WinkYoo/basic_bluetooth_car/README.md

# 项目名称：基础蓝牙小车

# 开发时间：2026.5.4 - 2026.5.8

# 开发板：STM32F103RCT6(正点原子mini)

# 开发工具：STM32CubeMX+Keil5

# 硬件模块：TB6612FNG电机驱动模块，HC-05蓝牙模块，LM2596降压模块，2块12v3500mA电池包

# 

# 功能描述：该小车类型为前驱小车。上电之后系统会发送‘system ready’，然后可以实现基础前进（发送‘f’），后退（发送‘b’），加减速（发送‘+，-’），停止（发送‘s’）和定差速转弯（发送‘r，l’）

# 

# 涉及问题：

# 1，上电之后烧毁驱动模块：上电有时序，需要先上vcc，再上vm，如果顺序反了则会烧掉模块

# 2，高频改变电机工作模式烧毁驱动模块：切换改变电机状态时瞬间电流过大，频繁切换状态会使驱动模块快速升温导致烧毁芯片——先stop pwm，再改变状态，再start pwm（不支持毫秒级切换）

# 3，在先前进或后退状态下，如果在进行左右转弯的途中进行加减速则会直接前进或后退：需要设置左右转弯时的电机状态，并在串口中断控制的加减速当中管理左右电机状态

# 4，不能正常走直线：跟重量分配，电机自身性能等有关——通过软件改变左右电机转速来控制，具体初始转速要根据实际情况而定
