WinkYoo/basic_bluetooth_car/basic_bluetooth_car/line_connection/HC-05蓝牙模块.png

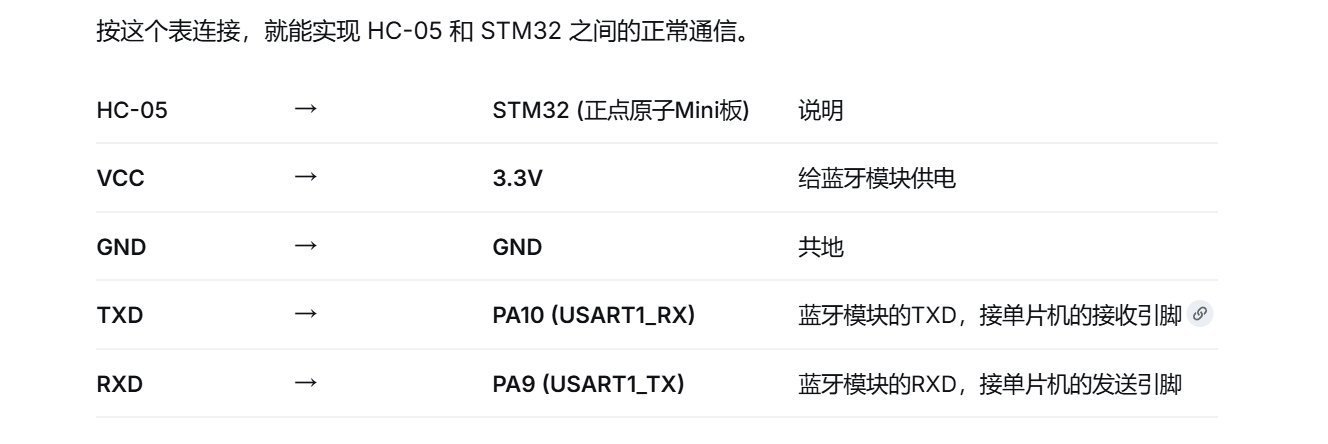
basic_bluetooth_car/line_connection/HC-05蓝牙模块.png
