WinkYoo/basic_bluetooth_car/basic_bluetooth_car/line_connection/接线_双（2）.png

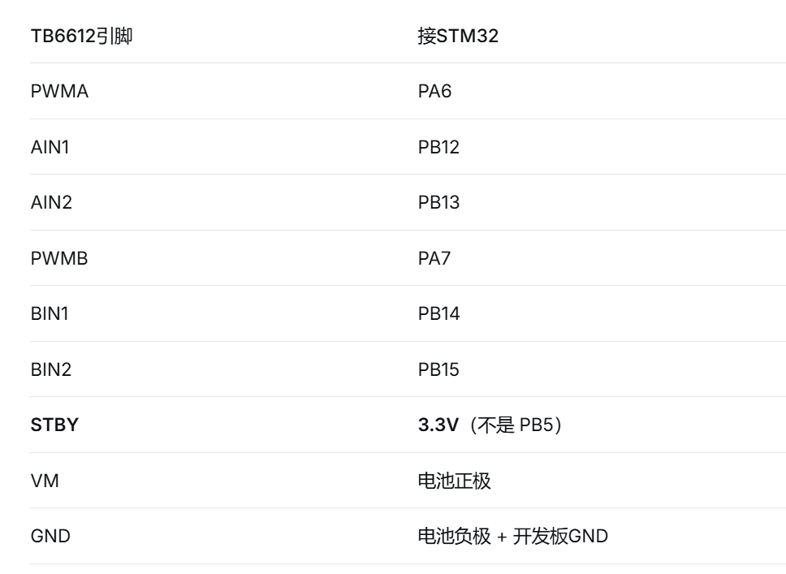
basic_bluetooth_car/line_connection/接线_双（2）.png
