WinkYoo/basic_bluetooth_car/basic_bluetooth_car/line_connection/接线（3）.jpg

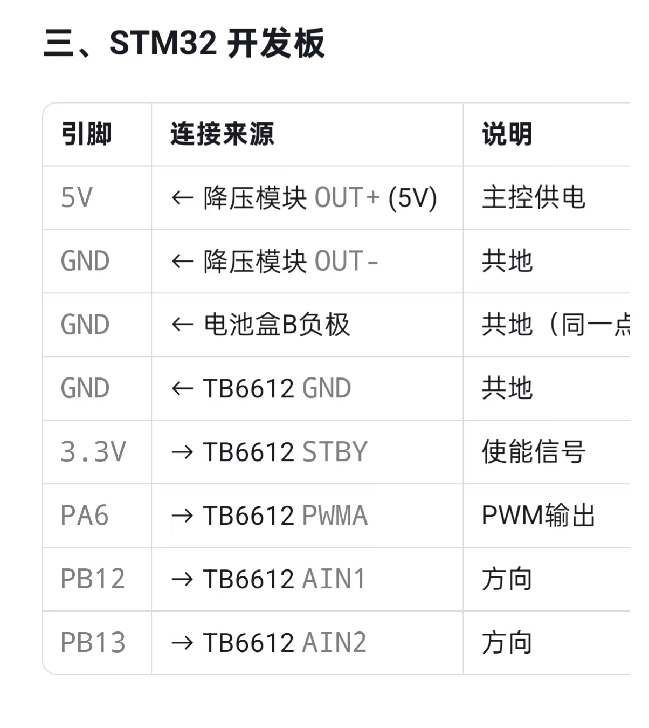
basic_bluetooth_car/line_connection/接线（3）.jpg
